Gmanmodz/64AMP/64AMP_firmware.X/CS2300CP.h

/* 
 * File:   CS2300CP_H
 * Author: Gunnar Turnquist
 *
 * Created on Jan 25, 20020, 10:27 AM
 */

#ifndef CS2300CP_H
#define CS2300CP_H

#include <xc.h>

void CS2300CP_write(unsigned char reg, char data);
void CS2300CP_init();

#endif
